laurent-fr/LFlex21/Readme.MD

# LFlex21, a single board 6809/Flex computer

   * 6809 CPU
   * 58Kb RAM
   * 4Kb ROM
   * 2Kb NVRAM
   * RTC clock
   * Serial interface up to 9600 bauds
   * Centronic printer port
   * floppy controller
   * FLEX09 operating system
