laurent-fr/LFlex21/kicad/mc6809.kicad_pcb

## KiCad design kicad/mc6809.kicad_pcb (2021-08-18)

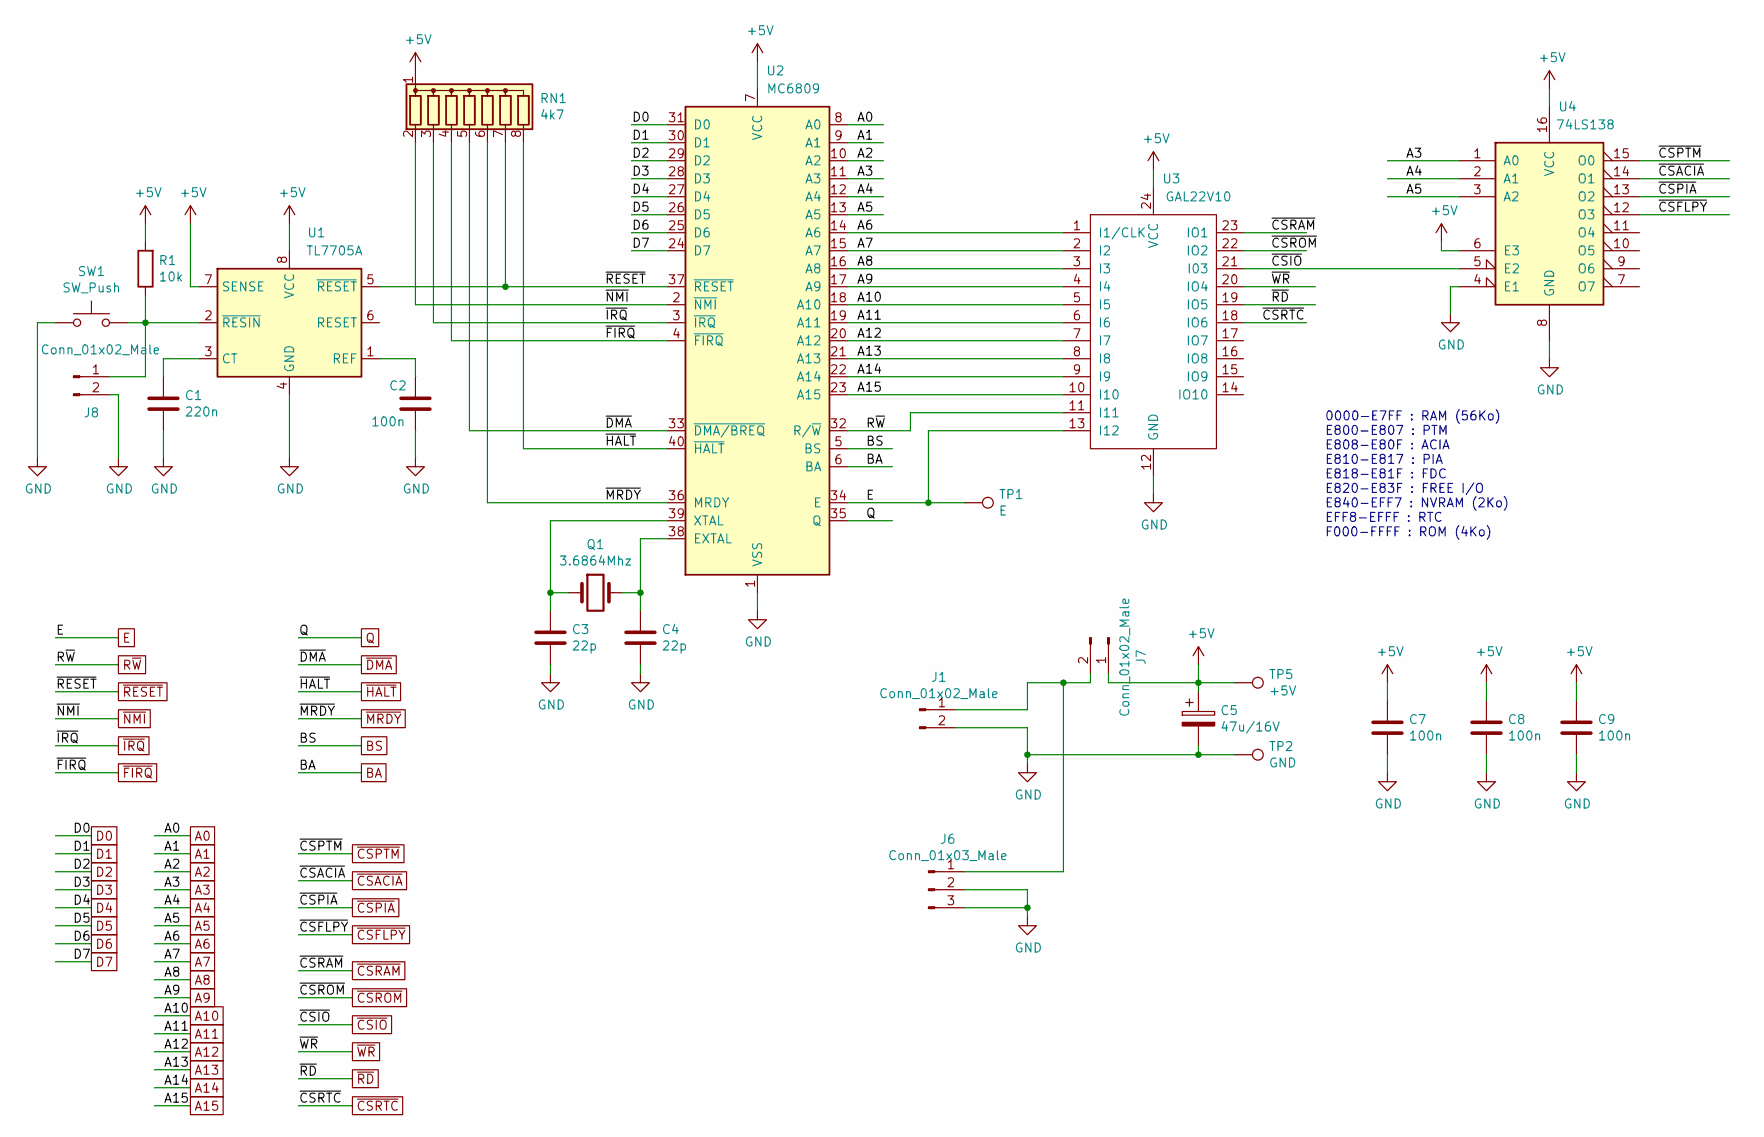
[picture p1: schematic cpu6809.sch]

Parts:
C1: 220n; C_Disc_D4.3mm_W1.9mm_P5.00mm
C2, C7, C8, C9: 100n; C_Disc_D4.3mm_W1.9mm_P5.00mm
C3, C4: 22p; C_Disc_D3.0mm_W1.6mm_P2.50mm
C5: 47u/16V; CP_Radial_D5.0mm_P2.50mm
J1: Conn_01x02_Male; JACK_ALIM
J6: Conn_01x03_Male; Molex_KK-6410-03_03x2.54mm_Straight
J7: Conn_01x02_Male; Molex_KK-6410-02_02x2.54mm_Straight
J8: Conn_01x02_Male; Pin_Header_Straight_1x02_Pitch2.54mm
Q1: 3.6864Mhz; Crystal_HC18-U_Vertical
R1: 10k; R_Axial_DIN0207_L6.3mm_D2.5mm_P7.62mm_Horizontal
RN1: 4k7; R_Array_SIP8
SW1: SW_Push; SW_PUSH_6mm
TP1: E; Pin_d1.0mm_L10.0mm
TP2: GND; Pin_d1.0mm_L10.0mm
TP5: +5V; Pin_d1.0mm_L10.0mm
U1: TL7705A; DIP-8_W7.62mm_LongPads
U2: MC6809; DIP-40_W15.24mm_LongPads
U3: GAL22V10; DIP-24_W7.62mm_LongPads
U4: 74LS138; DIP-16_W7.62mm_LongPads

Connections:
+5V: C5.1, C7.1, C8.1, C9.1, J7.1, R1.2, RN1.1 (common), TP5.1, U1.7 (SENSE), U1.8 (VCC), U2.7 (VCC), U3.24 (VCC), U4.6 (E3), U4.16 (VCC); also elsewhere on the board
A0: U2.8 (A0); also elsewhere on the board
A1: U2.9 (A1); also elsewhere on the board
A2: U2.10 (A2); also elsewhere on the board
A3: U2.11 (A3), U4.1 (A0); also elsewhere on the board
A4: U2.12 (A4), U4.2 (A1); also elsewhere on the board
A5: U2.13 (A5), U4.3 (A2); also elsewhere on the board
A6: U2.14 (A6), U3.1 (I1/CLK); also elsewhere on the board
A7: U2.15 (A7), U3.2 (I2); also elsewhere on the board
A8: U2.16 (A8), U3.3 (I3); also elsewhere on the board
A9: U2.17 (A9), U3.4 (I4); also elsewhere on the board
A10: U2.18 (A10), U3.5 (I5); also elsewhere on the board
A11: U2.19 (A11), U3.6 (I6); also elsewhere on the board
A12: U2.20 (A12), U3.7 (I7); also elsewhere on the board
A13: U2.21 (A13), U3.8 (I8); also elsewhere on the board
A14: U2.22 (A14), U3.9 (I9); also elsewhere on the board
A15: U2.23 (A15), U3.10 (I10); also elsewhere on the board
BA: U2.6 (BA); also elsewhere on the board
BS: U2.5 (BS); also elsewhere on the board
D0: U2.31 (D0); also elsewhere on the board
D1: U2.30 (D1); also elsewhere on the board
D2: U2.29 (D2); also elsewhere on the board
D3: U2.28 (D3); also elsewhere on the board
D4: U2.27 (D4); also elsewhere on the board
D5: U2.26 (D5); also elsewhere on the board
D6: U2.25 (D6); also elsewhere on the board
D7: U2.24 (D7); also elsewhere on the board
E: TP1.1, U2.34 (E), U3.13 (I12); also elsewhere on the board
GND: C1.2, C2.2, C3.2, C4.2, C5.2, C7.2, C8.2, C9.2, J1.2, J6.2, J6.3, J8.2, SW1.1, TP2.1, U1.4 (GND), U2.1 (VSS), U3.12 (GND), U4.4 (E1), U4.8 (GND); also elsewhere on the board
unnamed: C1.1, U1.3 (CT)
unnamed: C2.1, U1.1 (REF)
unnamed: C3.1, Q1.1, U2.39 (XTAL)
unnamed: C4.1, Q1.2, U2.38 (EXTAL)
unnamed: J1.1, J6.1, J7.2
unnamed: J8.1, R1.1, SW1.2, U1.2 (~RESIN)
Q: U2.35 (Q); also elsewhere on the board
R~W~: U2.32 (R/~W), U3.11 (I11); also elsewhere on the board
~CSACIA~: U4.14 (O1); also elsewhere on the board
~CSFLPY~: U4.12 (O3); also elsewhere on the board
~CSIO~: U3.21 (I03), U4.5 (E2); also elsewhere on the board
~CSPIA~: U4.13 (O2); also elsewhere on the board
~CSPTM~: U4.15 (O0); also elsewhere on the board
~CSRAM~: U3.23 (IO1); also elsewhere on the board
~CSROM~: U3.22 (IO2); also elsewhere on the board
~CSRTC~: U3.18 (IO6); also elsewhere on the board
~DMA~: RN1.5 (R4), U2.33 (~DMA/BREQ); also elsewhere on the board
~FIRQ~: RN1.4 (R3), U2.4 (~FIRQ); also elsewhere on the board
~HALT~: RN1.8 (R7), U2.40 (~HALT); also elsewhere on the board
~IRQ~: RN1.3 (R2), U2.3 (~IRQ); also elsewhere on the board
~MRDY~: RN1.6 (R5), U2.36 (MRDY); also elsewhere on the board
~NMI~: RN1.2 (R1), U2.2 (~NMI); also elsewhere on the board
~RD~: U3.19 (IO5); also elsewhere on the board
~RESET~: RN1.7 (R6), U1.5 (~RESET), U2.37 (~RESET); also elsewhere on the board
~WR~: U3.20 (IO4); also elsewhere on the board

Notes on the sheet:
0000-E7FF : RAM (56Ko) E800-E807 : PTM E808-E80F : ACIA E810-E817 : PIA E818-E81F : FDC E820-E83F : FREE I/O E840-EFF7 : NVRAM (2Ko) EFF8-EFFF : RTC F000-FFFF : ROM (4Ko)

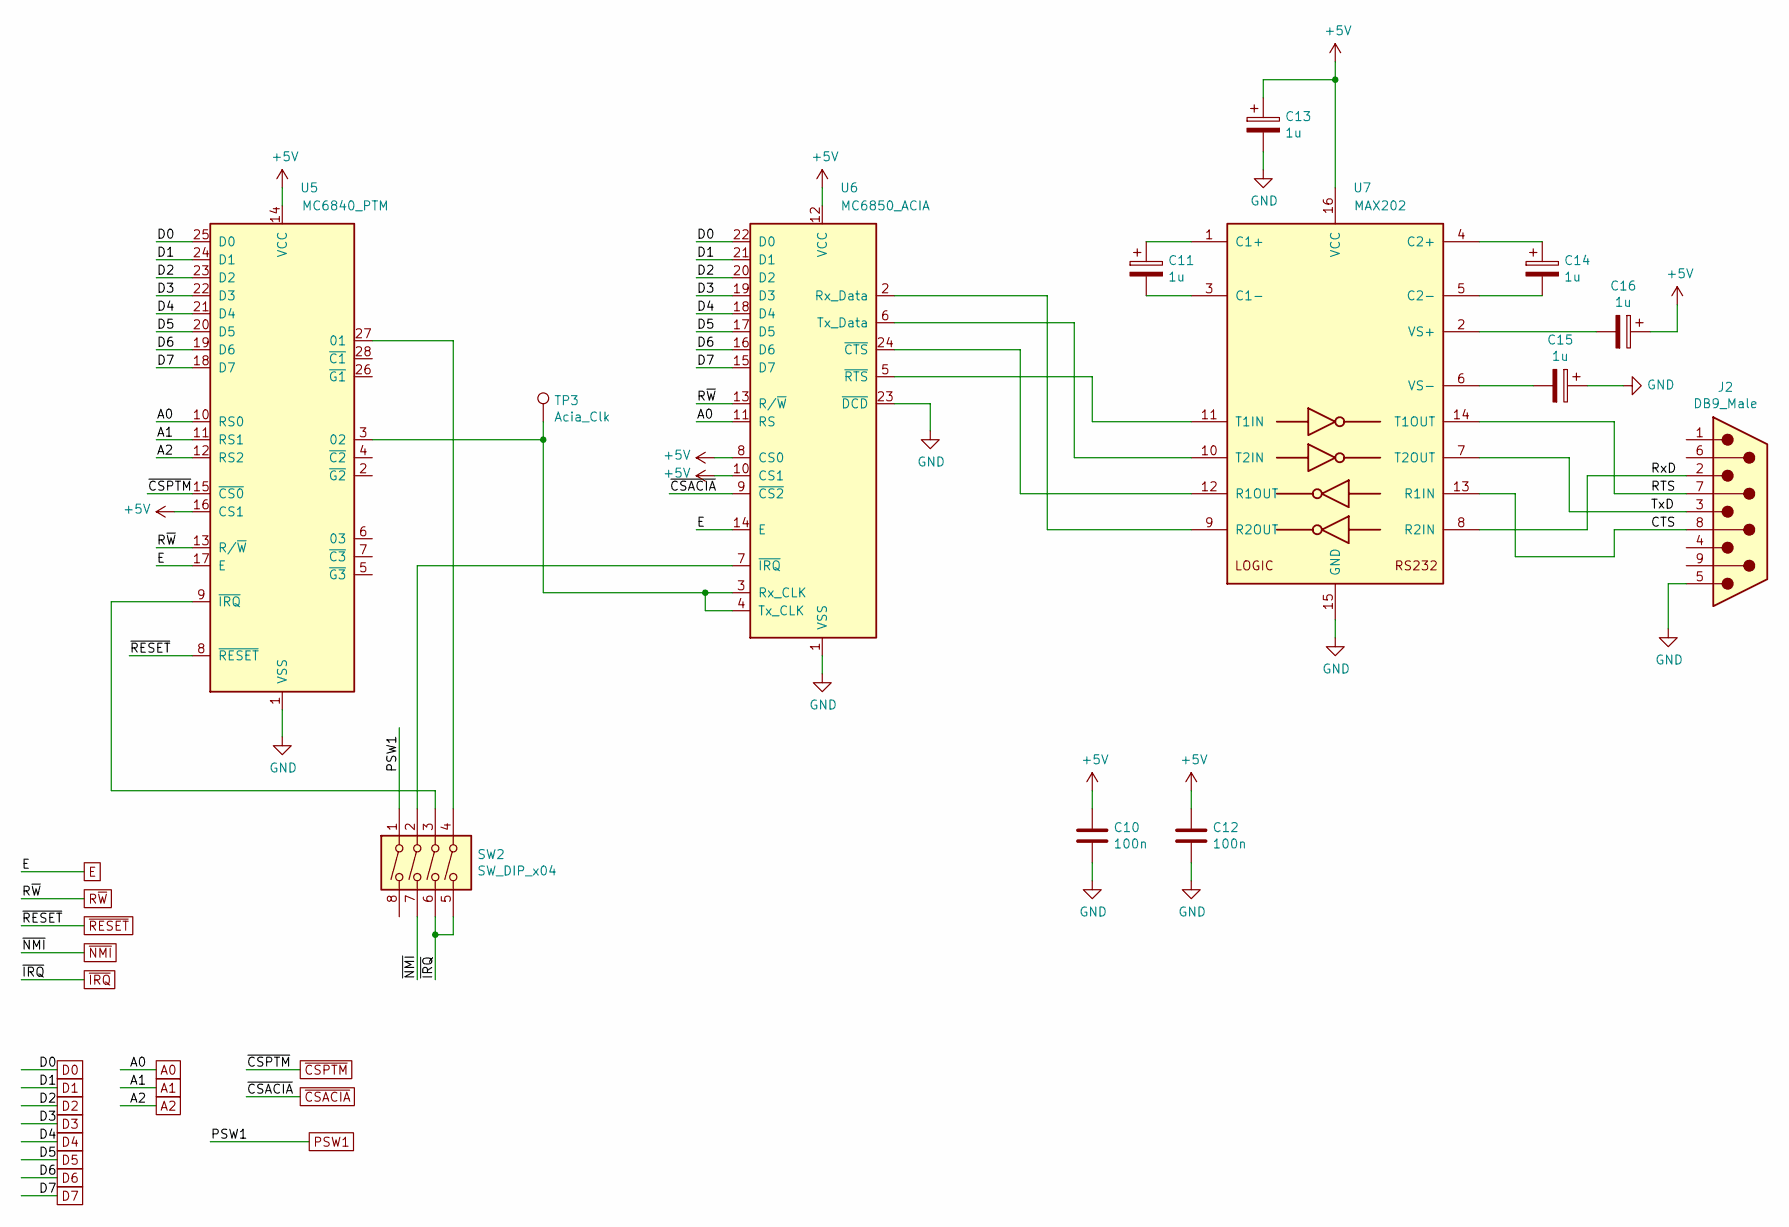
[picture p2: schematic serial.sch]

Parts:
C10, C12: 100n; C_Disc_D4.3mm_W1.9mm_P5.00mm
C11, C13, C14, C15, C16: 1u; CP_Radial_D5.0mm_P2.50mm
J2: DB9_Male; DSUB-9_Male_Horizontal_Pitch2.77x2.84mm_EdgePinOffset7.70mm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
SW2: SW_DIP_x04; SW_DIP_x4_W7.62mm_Slide
TP3: Acia_Clk; Pin_d1.0mm_L10.0mm
U5: MC6840_PTM; DIP-28_W15.24mm_LongPads
U6: MC6850_ACIA; DIP-24_W15.24mm_LongPads
U7: MAX202; DIP-16_W7.62mm_LongPads

Connections:
+5V: C10.1, C12.1, C13.1, C16.1, U5.14 (VCC), U5.16 (CS1), U6.8 (CS0), U6.10 (CS1), U6.12 (VCC), U7.16 (VCC); also elsewhere on the board
/serial/CTS: J2.8, U7.13 (R1IN)
/serial/RTS: J2.7, U7.14 (T1OUT)
/serial/RxD: J2.2, U7.8 (R2IN)
/serial/TxD: J2.3, U7.7 (T2OUT)
A0: U5.10 (RS0), U6.11 (RS); also elsewhere on the board
A1: U5.11 (RS1); also elsewhere on the board
A2: U5.12 (RS2); also elsewhere on the board
D0: U5.25 (D0), U6.22 (D0); also elsewhere on the board
D1: U5.24 (D1), U6.21 (D1); also elsewhere on the board
D2: U5.23 (D2), U6.20 (D2); also elsewhere on the board
D3: U5.22 (D3), U6.19 (D3); also elsewhere on the board
D4: U5.21 (D4), U6.18 (D4); also elsewhere on the board
D5: U5.20 (D5), U6.17 (D5); also elsewhere on the board
D6: U5.19 (D6), U6.16 (D6); also elsewhere on the board
D7: U5.18 (D7), U6.15 (D7); also elsewhere on the board
E: U5.17 (E), U6.14 (E); also elsewhere on the board
GND: C10.2, C12.2, C13.2, C15.1, J2.5, U5.1 (VSS), U6.1 (VSS), U6.23 (~DCD), U7.15 (GND); also elsewhere on the board
unnamed: C11.1, U7.1 (C1+)
unnamed: C11.2, U7.3 (C1-)
unnamed: C14.1, U7.4 (C2+)
unnamed: C14.2, U7.5 (C2-)
unnamed: C15.2, U7.6 (VS-)
unnamed: C16.2, U7.2 (VS+)
unnamed: SW2.2, U6.7 (~IRQ)
unnamed: SW2.3, U5.9 (~IRQ)
unnamed: SW2.4, U5.27 (01)
unnamed: TP3.1, U5.3 (02), U6.3 (Rx_CLK), U6.4 (Tx_CLK)
unnamed: U6.2 (Rx_Data), U7.9 (R2OUT)
unnamed: U6.5 (~RTS), U7.11 (T1IN)
unnamed: U6.6 (Tx_Data), U7.10 (T2IN)
unnamed: U6.24 (~CTS), U7.12 (R1OUT)
PSW1: SW2.1; also elsewhere on the board
R~W~: U5.13 (R/~W), U6.13 (R/~W); also elsewhere on the board
~CSACIA~: U6.9 (~CS2~); also elsewhere on the board
~CSPTM~: U5.15 (~CS0~); also elsewhere on the board
~IRQ~: SW2.5, SW2.6; also elsewhere on the board
~NMI~: SW2.7; also elsewhere on the board
~RESET~: U5.8 (~RESET); also elsewhere on the board

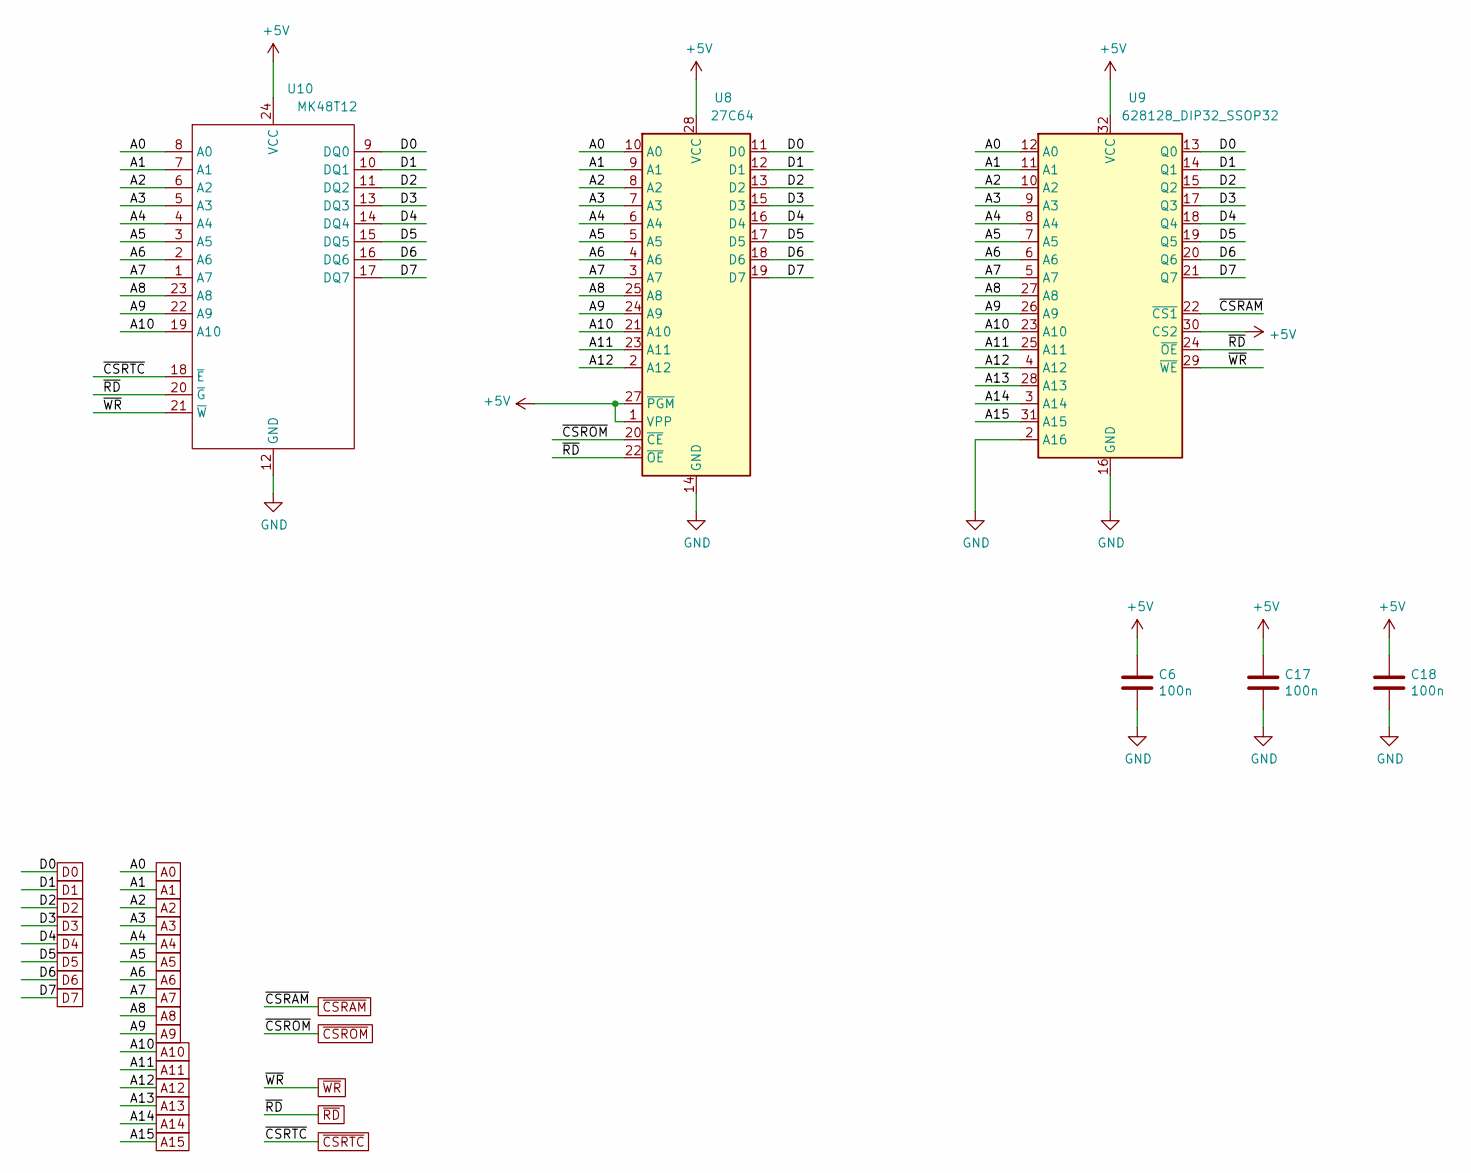
[picture p3: schematic mem.sch]

Parts:
C6, C17, C18: 100n; C_Disc_D4.3mm_W1.9mm_P5.00mm
U8: 27C64; DIP-28_W15.24mm_LongPads
U9: 628128_DIP32_SSOP32; DIP-32_W15.24mm_LongPads
U10: MK48T12; DIP-24_W15.24mm_LongPads

Connections:
+5V: C6.1, C17.1, C18.1, U8.1 (VPP), U8.27 (~PGM), U8.28 (VCC), U9.30 (CS2), U9.32 (VCC), U10.24 (VCC); also elsewhere on the board
A0: U8.10 (A0), U9.12 (A0), U10.8 (A0); also elsewhere on the board
A1: U8.9 (A1), U9.11 (A1), U10.7 (A1); also elsewhere on the board
A2: U8.8 (A2), U9.10 (A2), U10.6 (A2); also elsewhere on the board
A3: U8.7 (A3), U9.9 (A3), U10.5 (A3); also elsewhere on the board
A4: U8.6 (A4), U9.8 (A4), U10.4 (A4); also elsewhere on the board
A5: U8.5 (A5), U9.7 (A5), U10.3 (A5); also elsewhere on the board
A6: U8.4 (A6), U9.6 (A6), U10.2 (A6); also elsewhere on the board
A7: U8.3 (A7), U9.5 (A7), U10.1 (A7); also elsewhere on the board
A8: U8.25 (A8), U9.27 (A8), U10.23 (A8); also elsewhere on the board
A9: U8.24 (A9), U9.26 (A9), U10.22 (A9); also elsewhere on the board
A10: U8.21 (A10), U9.23 (A10), U10.19 (A10); also elsewhere on the board
A11: U8.23 (A11), U9.25 (A11); also elsewhere on the board
A12: U8.2 (A12), U9.4 (A12); also elsewhere on the board
A13: U9.28 (A13); also elsewhere on the board
A14: U9.3 (A14); also elsewhere on the board
A15: U9.31 (A15); also elsewhere on the board
D0: U8.11 (D0), U9.13 (Q0), U10.9 (DQ0); also elsewhere on the board
D1: U8.12 (D1), U9.14 (Q1), U10.10 (DQ1); also elsewhere on the board
D2: U8.13 (D2), U9.15 (Q2), U10.11 (DQ2); also elsewhere on the board
D3: U8.15 (D3), U9.17 (Q3), U10.13 (DQ3); also elsewhere on the board
D4: U8.16 (D4), U9.18 (Q4), U10.14 (DQ4); also elsewhere on the board
D5: U8.17 (D5), U9.19 (Q5), U10.15 (DQ5); also elsewhere on the board
D6: U8.18 (D6), U9.20 (Q6), U10.16 (DQ6); also elsewhere on the board
D7: U8.19 (D7), U9.21 (Q7), U10.17 (DQ7); also elsewhere on the board
GND: C6.2, C17.2, C18.2, U8.14 (GND), U9.2 (A16), U9.16 (GND), U10.12 (GND); also elsewhere on the board
~CSRAM~: U9.22 (~CS1); also elsewhere on the board
~CSROM~: U8.20 (~CE); also elsewhere on the board
~CSRTC~: U10.18 (~E~); also elsewhere on the board
~RD~: U8.22 (~OE), U9.24 (~OE), U10.20 (~G~); also elsewhere on the board
~WR~: U9.29 (~WE), U10.21 (~W~); also elsewhere on the board

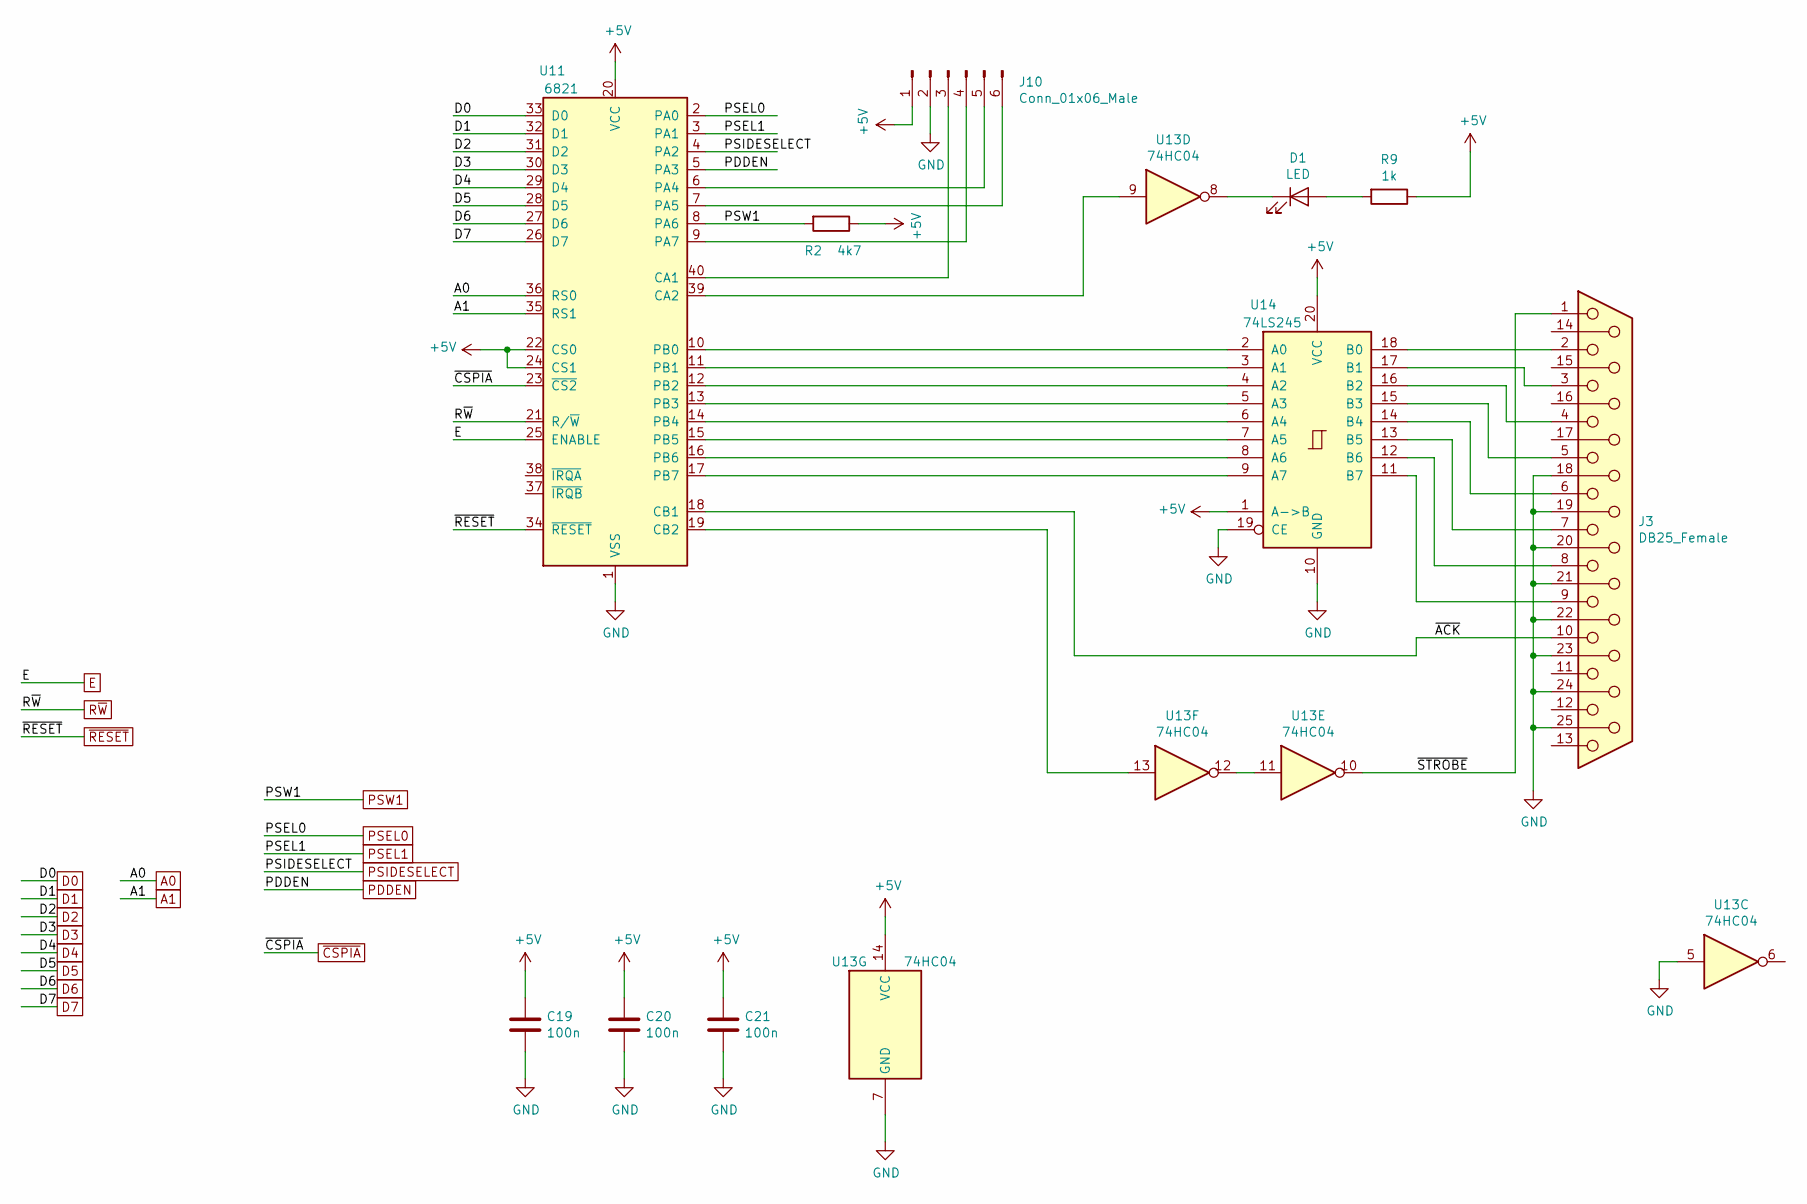
[picture p4: schematic pia.sch]

Parts:
C19, C20, C21: 100n; C_Disc_D4.3mm_W1.9mm_P5.00mm
D1: LED; LED_D3.0mm
J3: DB25_Female; DSUB-25_Female_Horizontal_Pitch2.77x2.84mm_EdgePinOffset7.7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
J10: Conn_01x06_Male; Pin_Header_Straight_1x06_Pitch2.54mm
R2: 4k7; R_Axial_DIN0207_L6.3mm_D2.5mm_P7.62mm_Horizontal
R9: 1k; R_Axial_DIN0207_L6.3mm_D2.5mm_P7.62mm_Horizontal
U11: 6821; DIP-40_W15.24mm_LongPads
U13: 74HC04; DIP-14_W7.62mm_LongPads
U14: 74LS245; DIP-20_W7.62mm_LongPads

Connections:
+5V: C19.1, C20.1, C21.1, J10.1, R2.1, R9.1, U11.20 (VCC), U11.22 (CS0), U11.24 (CS1), U13.14 (VCC), U14.1 (A->B), U14.20 (VCC); also elsewhere on the board
/pia/~ACK~: J3.10, U11.18 (CB1)
/pia/~STROBE~: J3.1, U13.10
A0: U11.36 (RS0); also elsewhere on the board
A1: U11.35 (RS1); also elsewhere on the board
D0: U11.33 (D0); also elsewhere on the board
D1: U11.32 (D1); also elsewhere on the board
D2: U11.31 (D2); also elsewhere on the board
D3: U11.30 (D3); also elsewhere on the board
D4: U11.29 (D4); also elsewhere on the board
D5: U11.28 (D5); also elsewhere on the board
D6: U11.27 (D6); also elsewhere on the board
D7: U11.26 (D7); also elsewhere on the board
E: U11.25 (ENABLE); also elsewhere on the board
GND: C19.2, C20.2, C21.2, J3.18, J3.19, J3.20, J3.21, J3.22, J3.23, J3.24, J3.25, J10.2, U11.1 (VSS), U13.5, U13.7 (GND), U14.10 (GND), U14.19 (CE); also elsewhere on the board
unnamed: D1.1 (K), U13.8
unnamed: D1.2 (A), R9.2
unnamed: J3.2, U14.18 (B0)
unnamed: J3.3, U14.17 (B1)
unnamed: J3.4, U14.16 (B2)
unnamed: J3.5, U14.15 (B3)
unnamed: J3.6, U14.14 (B4)
unnamed: J3.7, U14.13 (B5)
unnamed: J3.8, U14.12 (B6)
unnamed: J3.9, U14.11 (B7)
unnamed: J10.3, U11.40 (CA1)
unnamed: J10.4, U11.9 (PA7)
unnamed: J10.5, U11.6 (PA4)
unnamed: J10.6, U11.7 (PA5)
unnamed: U11.10 (PB0), U14.2 (A0)
unnamed: U11.11 (PB1), U14.3 (A1)
unnamed: U11.12 (PB2), U14.4 (A2)
unnamed: U11.13 (PB3), U14.5 (A3)
unnamed: U11.14 (PB4), U14.6 (A4)
unnamed: U11.15 (PB5), U14.7 (A5)
unnamed: U11.16 (PB6), U14.8 (A6)
unnamed: U11.17 (PB7), U14.9 (A7)
unnamed: U11.19 (CB2), U13.13
unnamed: U11.39 (CA2), U13.9
unnamed: U13.11, U13.12
PDDEN: U11.5 (PA3); also elsewhere on the board
PSEL0: U11.2 (PA0); also elsewhere on the board
PSEL1: U11.3 (PA1); also elsewhere on the board
PSIDESELECT: U11.4 (PA2); also elsewhere on the board
PSW1: R2.2, U11.8 (PA6); also elsewhere on the board
R~W~: U11.21 (R/~W); also elsewhere on the board
~CSPIA~: U11.23 (~CS2); also elsewhere on the board
~RESET~: U11.34 (~RESET); also elsewhere on the board

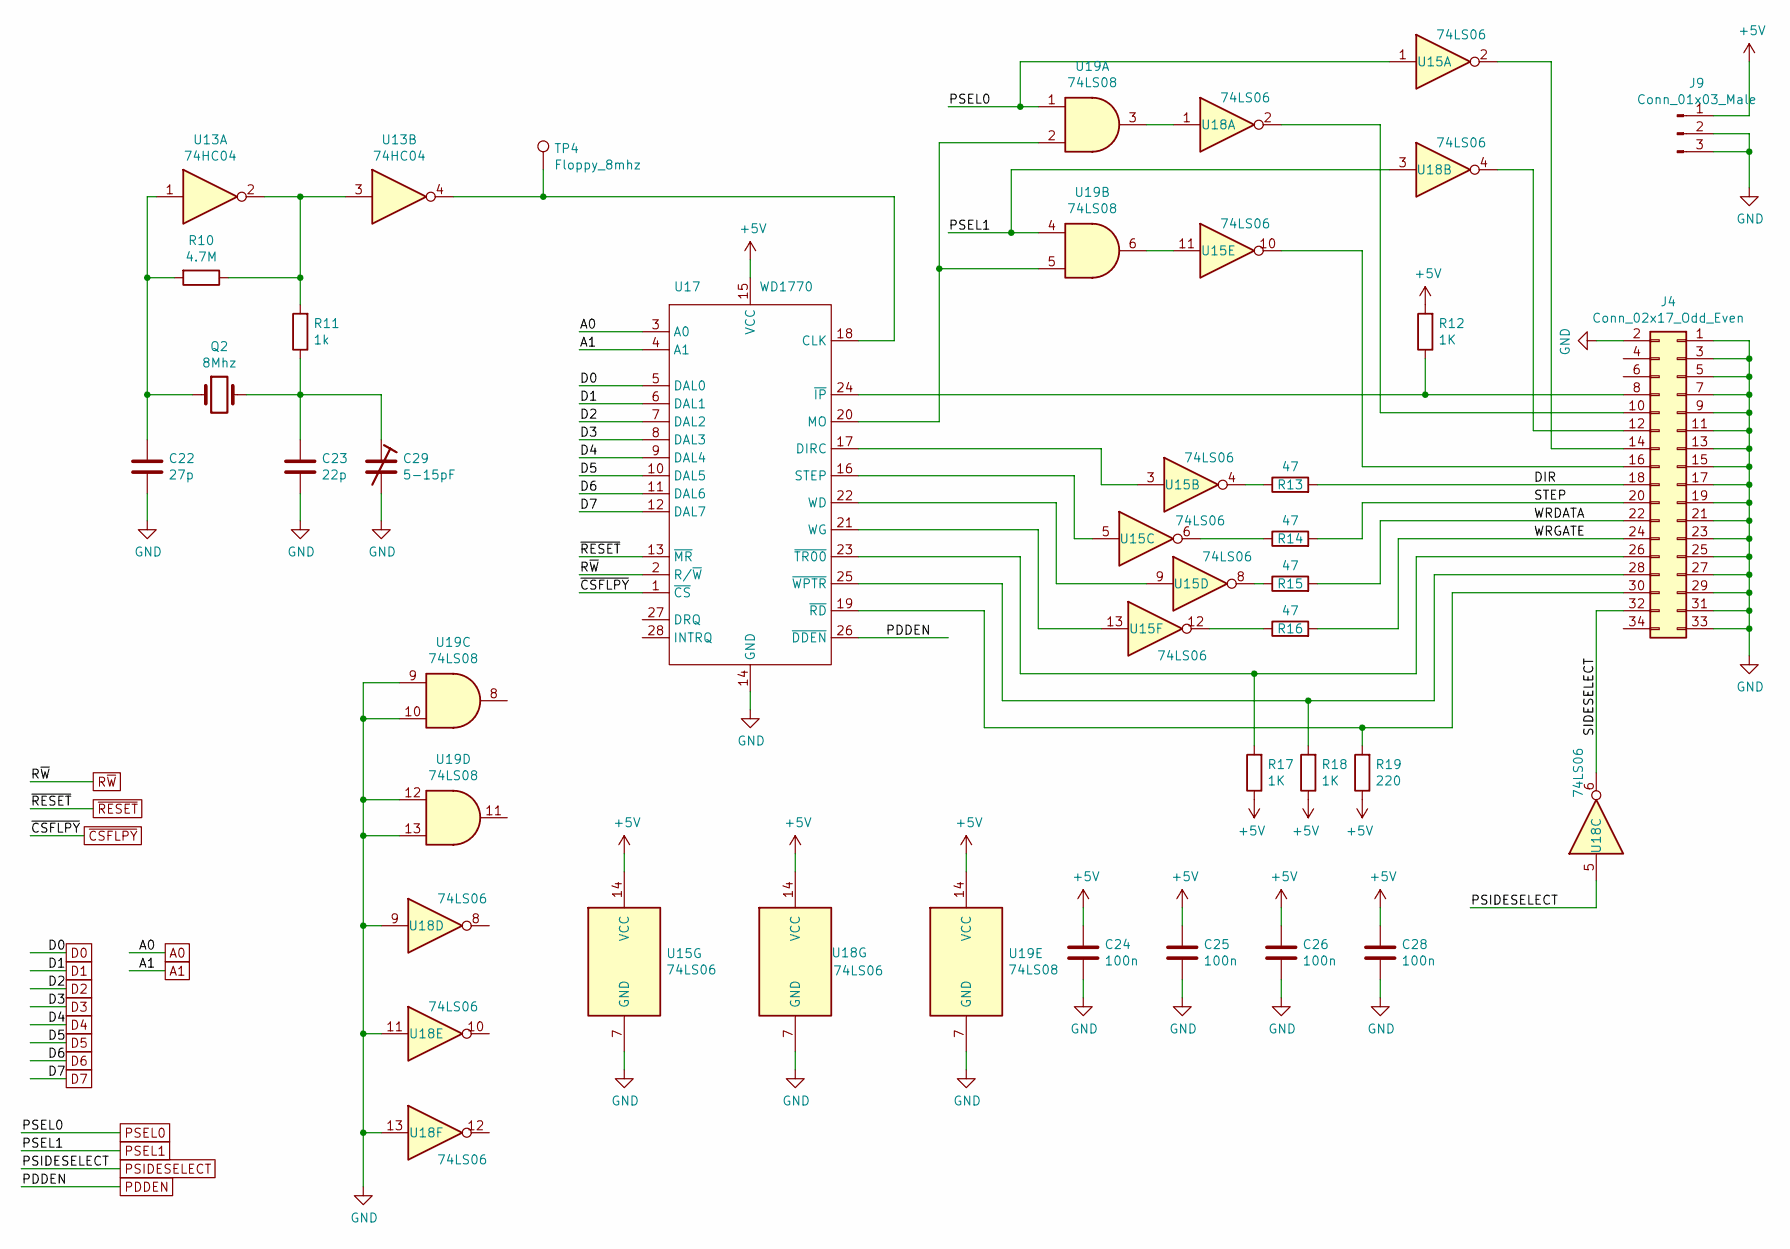
[picture p5: schematic floppy.sch]

Parts:
C22: 27p; C_Disc_D3.0mm_W1.6mm_P2.50mm
C23: 22p; C_Disc_D3.0mm_W1.6mm_P2.50mm
C24, C25, C26, C28: 100n; C_Disc_D4.3mm_W1.9mm_P5.00mm
C29: 5-15pF; C-TRIMMER-5
J4: Conn_02x17_Odd_Even; Multicomp_MC9A12-3434_2x17x2.54mm_Straight
J9: Conn_01x03_Male; Molex_KK-6410-03_03x2.54mm_Straight
Q2: 8Mhz; Crystal_HC18-U_Vertical
R10: 4.7M; R_Axial_DIN0207_L6.3mm_D2.5mm_P7.62mm_Horizontal
R11: 1k; R_Axial_DIN0207_L6.3mm_D2.5mm_P7.62mm_Horizontal
R12, R17, R18: 1K; R_Axial_DIN0204_L3.6mm_D1.6mm_P7.62mm_Horizontal
R13, R14, R15, R16: 47; R_Axial_DIN0204_L3.6mm_D1.6mm_P7.62mm_Horizontal
R19: 220; R_Axial_DIN0204_L3.6mm_D1.6mm_P7.62mm_Horizontal
TP4: Floppy_8mhz; Pin_d1.0mm_L10.0mm
U13: 74HC04; DIP-14_W7.62mm_LongPads
U15, U18: 74LS06; DIP-14_W7.62mm_LongPads
U17: WD1770; DIP-28_W15.24mm_LongPads
U19: 74LS08; DIP-14_W7.62mm_LongPads

Connections:
+5V: C24.1, C25.1, C26.1, C28.1, J9.1, R12.2, R17.1, R18.1, R19.1, U15.14 (VCC), U17.15 (VCC), U18.14 (VCC), U19.14 (VCC); also elsewhere on the board
/floppy/DIR: J4.18, R13.2
/floppy/SIDESELECT: J4.32, U18.6
/floppy/STEP: J4.20, R14.2
/floppy/WRDATA: J4.22, R15.2
/floppy/WRGATE: J4.24, R16.2
A0: U17.3 (A0); also elsewhere on the board
A1: U17.4 (A1); also elsewhere on the board
D0: U17.5 (DAL0); also elsewhere on the board
D1: U17.6 (DAL1); also elsewhere on the board
D2: U17.7 (DAL2); also elsewhere on the board
D3: U17.8 (DAL3); also elsewhere on the board
D4: U17.9 (DAL4); also elsewhere on the board
D5: U17.10 (DAL5); also elsewhere on the board
D6: U17.11 (DAL6); also elsewhere on the board
D7: U17.12 (DAL7); also elsewhere on the board
GND: C22.2, C23.2, C24.2, C25.2, C26.2, C28.2, C29.2, J4.1, J4.2, J4.3, J4.5, J4.7, J4.9, J4.11, J4.13, J4.15, J4.17, J4.19, J4.21, J4.23, J4.25, J4.27, J4.29, J4.31, J4.33, J9.2, J9.3, U15.7 (GND), U17.14 (GND), U18.7 (GND), U18.9, U18.11, U18.13, U19.7 (GND), U19.9, U19.10, U19.12, U19.13; also elsewhere on the board
unnamed: C22.1, Q2.1, R10.2, U13.1
unnamed: C23.1, C29.1, Q2.2, R11.1
unnamed: J4.8, R12.1, U17.24 (~IP~)
unnamed: J4.10, U18.2
unnamed: J4.12, U18.4
unnamed: J4.14, U15.2
unnamed: J4.16, U15.10
unnamed: J4.26, R17.2, U17.23 (~TR00~)
unnamed: J4.28, R18.2, U17.25 (~WPTR~)
unnamed: J4.30, R19.2, U17.19 (~RD~)
unnamed: R10.1, R11.2, U13.2, U13.3
unnamed: R13.1, U15.4
unnamed: R14.1, U15.6
unnamed: R15.1, U15.8
unnamed: R16.1, U15.12
unnamed: TP4.1, U13.4, U17.18 (CLK)
unnamed: U15.3, U17.17 (DIRC)
unnamed: U15.5, U17.16 (STEP)
unnamed: U15.9, U17.22 (WD)
unnamed: U15.11, U19.6
unnamed: U15.13, U17.21 (WG)
unnamed: U17.20 (MO), U19.2, U19.5
unnamed: U18.1, U19.3
PDDEN: U17.26 (~DDEN~); also elsewhere on the board
PSEL0: U15.1, U19.1; also elsewhere on the board
PSEL1: U18.3, U19.4; also elsewhere on the board
PSIDESELECT: U18.5; also elsewhere on the board
R~W~: U17.2 (R/~W~); also elsewhere on the board
~CSFLPY~: U17.1 (~CS~); also elsewhere on the board
~RESET~: U17.13 (~MR~); also elsewhere on the board

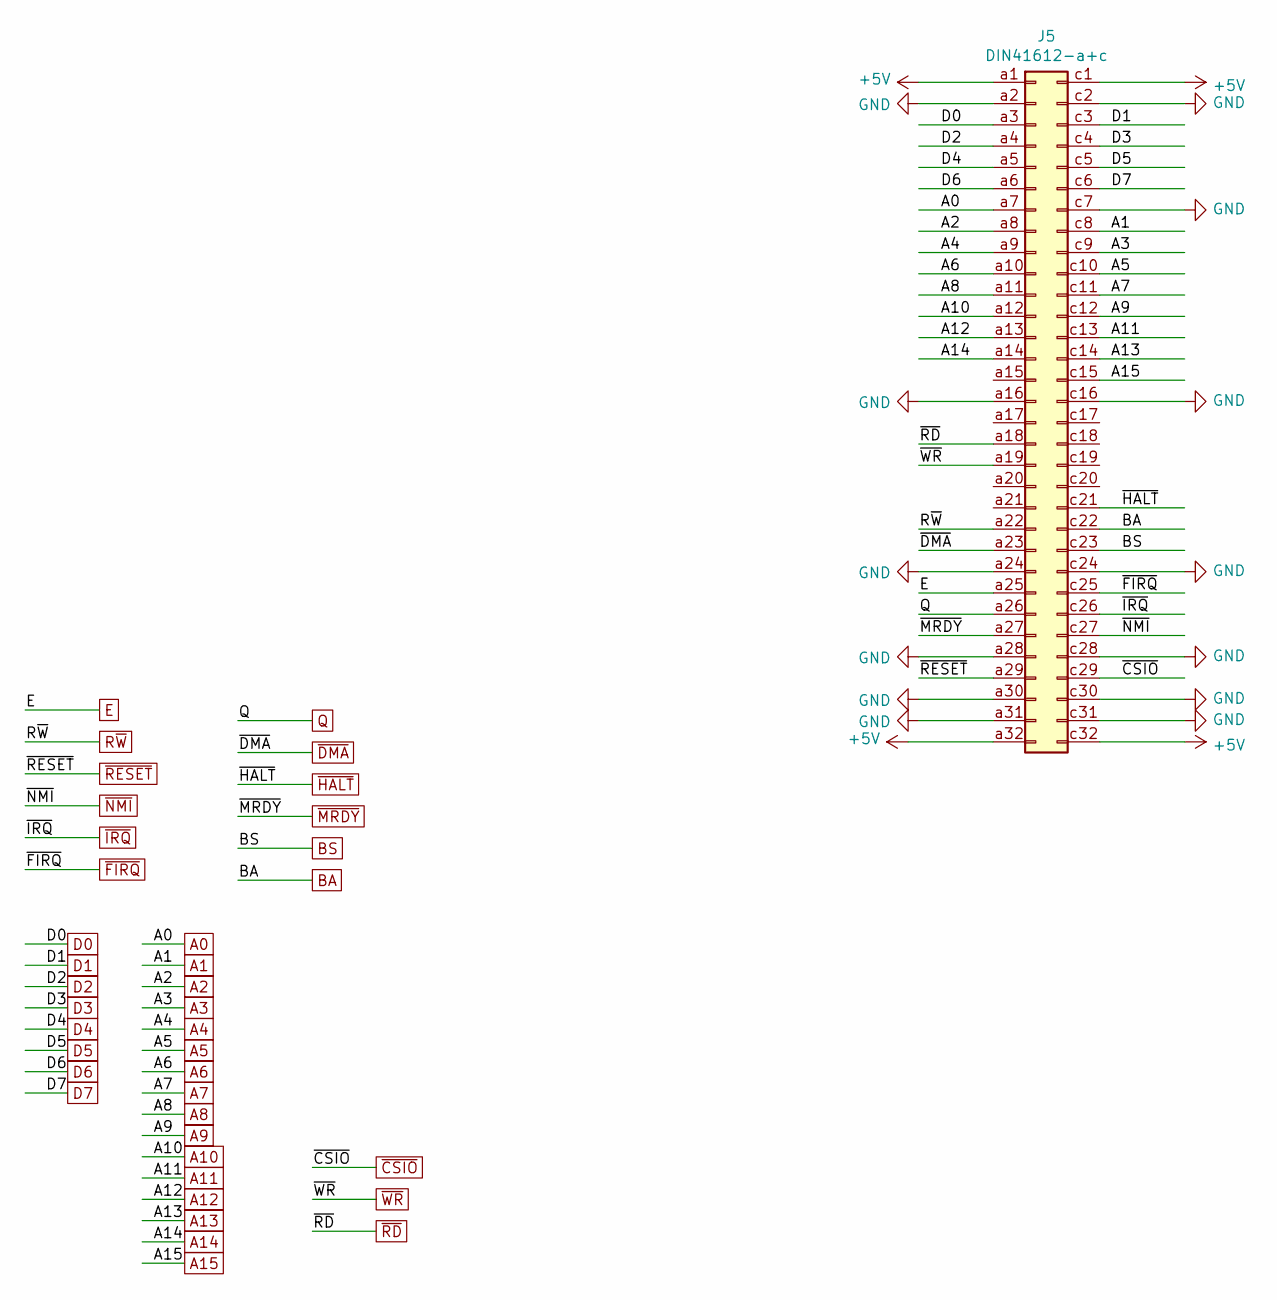
[picture p6: schematic ext.sch]

Parts:
J5: DIN41612-a+c; Socket_DIN41612-CaseC1-AC-Male-64Pin-2rows-nosilk

Connections:
+5V: J5.a1, J5.a32, J5.c1, J5.c32; also elsewhere on the board
A0: J5.a7; also elsewhere on the board
A1: J5.c8; also elsewhere on the board
A2: J5.a8; also elsewhere on the board
A3: J5.c9; also elsewhere on the board
A4: J5.a9; also elsewhere on the board
A5: J5.c10; also elsewhere on the board
A6: J5.a10; also elsewhere on the board
A7: J5.c11; also elsewhere on the board
A8: J5.a11; also elsewhere on the board
A9: J5.c12; also elsewhere on the board
A10: J5.a12; also elsewhere on the board
A11: J5.c13; also elsewhere on the board
A12: J5.a13; also elsewhere on the board
A13: J5.c14; also elsewhere on the board
A14: J5.a14; also elsewhere on the board
A15: J5.c15; also elsewhere on the board
BA: J5.c22; also elsewhere on the board
BS: J5.c23; also elsewhere on the board
D0: J5.a3; also elsewhere on the board
D1: J5.c3; also elsewhere on the board
D2: J5.a4; also elsewhere on the board
D3: J5.c4; also elsewhere on the board
D4: J5.a5; also elsewhere on the board
D5: J5.c5; also elsewhere on the board
D6: J5.a6; also elsewhere on the board
D7: J5.c6; also elsewhere on the board
E: J5.a25; also elsewhere on the board
GND: J5.a2, J5.a16, J5.a24, J5.a28, J5.a30, J5.a31, J5.c2, J5.c7, J5.c16, J5.c24, J5.c28, J5.c30, J5.c31; also elsewhere on the board
Q: J5.a26; also elsewhere on the board
R~W~: J5.a22; also elsewhere on the board
~CSIO~: J5.c29; also elsewhere on the board
~DMA~: J5.a23; also elsewhere on the board
~FIRQ~: J5.c25; also elsewhere on the board
~HALT~: J5.c21; also elsewhere on the board
~IRQ~: J5.c26; also elsewhere on the board
~MRDY~: J5.a27; also elsewhere on the board
~NMI~: J5.c27; also elsewhere on the board
~RD~: J5.a18; also elsewhere on the board
~RESET~: J5.a29; also elsewhere on the board
~WR~: J5.a19; also elsewhere on the board

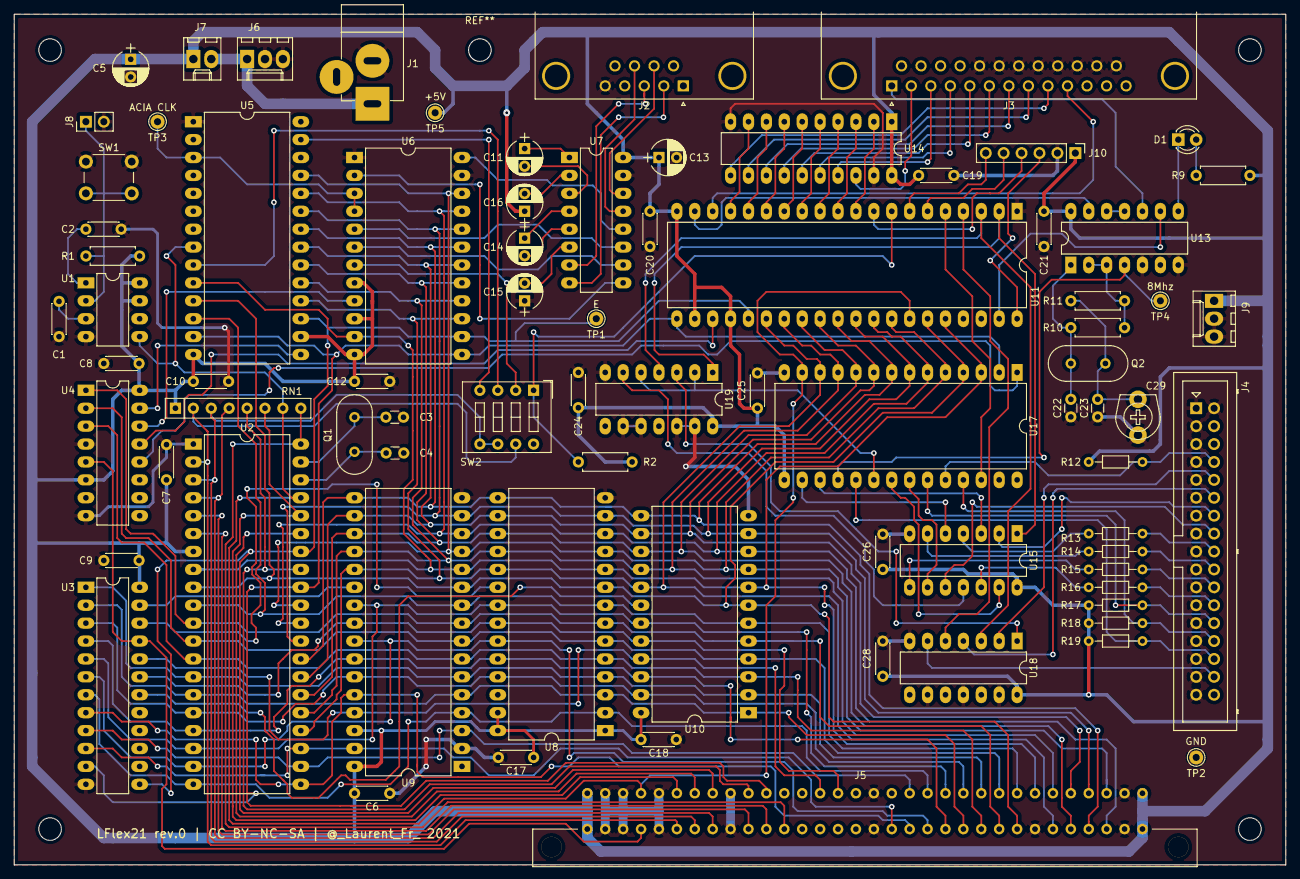
[picture p7: board mc6809.kicad_pcb from above]

Board: 2 copper layers, 180.3 x 120.6 mm, 79 parts (0 on the bottom side), 132 nets.
