laurent-fr/LFlex21/(commit log)

2021-08-09 adding README
    [mem.sch]
2021-08-11 Ajout de Assist09
2021-08-16 Adding PCB layout
    [cpu6809.sch, ext.sch, floppy.sch, mc6809.kicad_pcb, mc6809.sch, mem.sch, pia.sch, serial.sch]
2021-08-18 Adding PCB
    [ext.sch, floppy.sch, mc6809.kicad_pcb, pia.sch]
