laurent-fr/LFlex21/(notices)

Notices in the files:
kicad/mc6809.kicad_pcb:
LFlex21 rev.0 | CC BY-NC-SA | @_Laurent_Fr_ 2021
